ibbu98/BOARD-2-HEX-INVERTER/SCHEMATICS/hex-inverter-schematics.pdf

# Power Conditioning

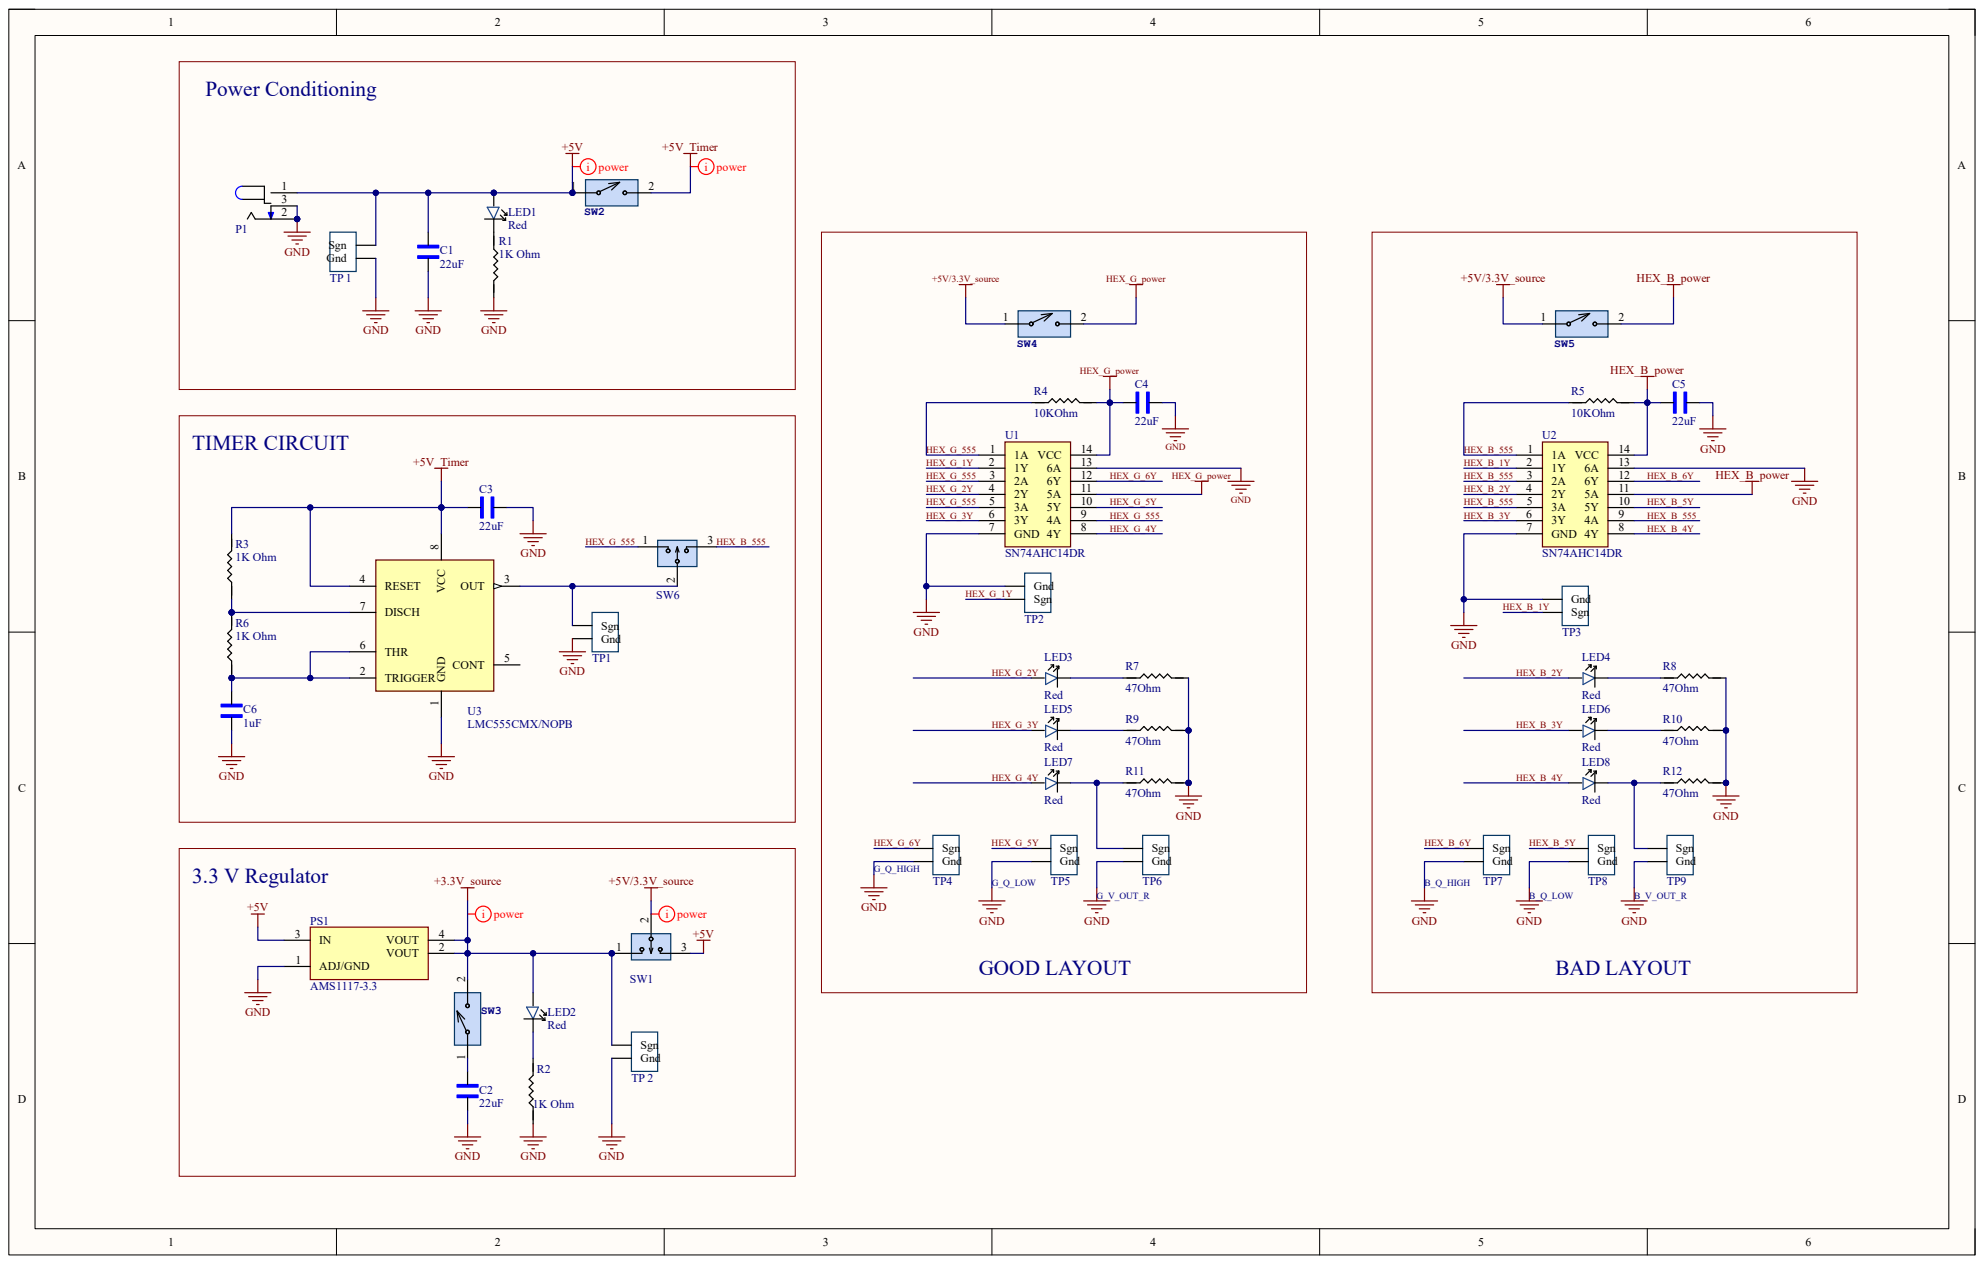
[picture p21: page 1]
