ibbu98/BOARD-2-HEX-INVERTER/LAYOUT/hex-inverter-layout.pdf

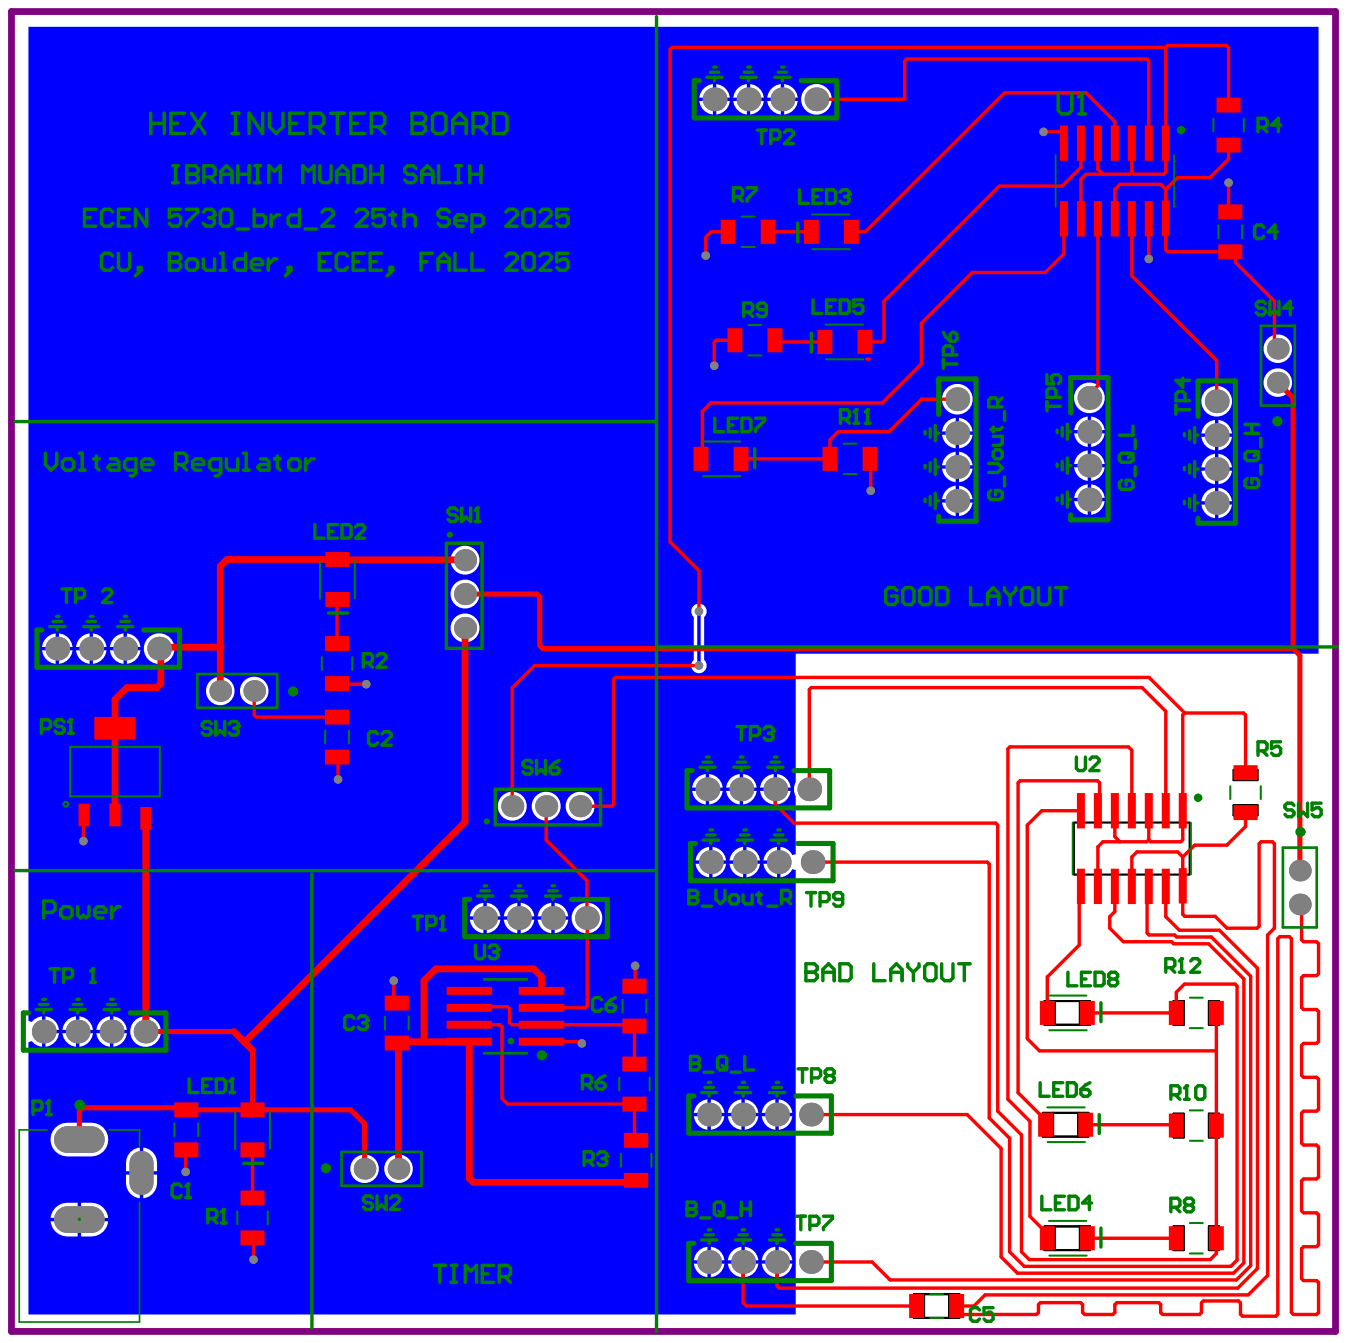
[picture p22: page 1]
