ibbu98/BOARD-2-HEX-INVERTER/(list of files, drawings)

Other design files:
LAYOUT/hex-inverter.PcbDoc
SCHEMATICS/hex-inverter.SchDoc
