ibbu98/BOARD-2-HEX-INVERTER/(commit log)

2025-11-16 Add title for HEX INVERTER schematics
2025-11-16 Add README for REPORT O HEX INVERTER BOARD
